azinedine456/Grid-Tied-Inverter-Design-for-a-50V-PV-Array/README.md

# Grid-Tied-Inverter-Design-for-a-50V-PV-Array

This is the github reposity of an academic project at the EiCNAM. (LTspice model uses the [LTspiceControlLibrary-master](https://github.com/kanedahiroshi/LTspiceControlLibrary) library.) 

## Project Objectives 
- Developing the methodological skills necessary to effectively plan and manage a technical project.
- Designing & properly sizing an inverter leg that meets project specifications.
- Simulating a full inverter on LTspice.
- Experimenting with different controllers & evaluating current control system performance (Proportional / Hysterisis). 

## LTSpice Ciruict & Simulation 
- High current peaks are due to  diode reverse recovery current => LC input filter needed.



## Results (Hysterisis Controller Implementation on Arduino)
TEK00016

-Pink: Current 
-Red: Current Reference
-Blue: Grid Voltage

## Sizing xlsx File Overview
