azinedine456/Grid-Tied-Inverter-Design-for-a-50V-PV-Array/Project Files /LTspice/ReadMe.Md

# All files ending in ANALOG contain a conventional implementation of the hysterisis controller.

# All files ending in PWN contain a PWM implementation of the hysterisis controller.
