azinedine456/Grid-Tied-Inverter-Design-for-a-50V-PV-Array/Project Files /LTspice/IDEAL SWITCH TEST.asc

B1: bv; V=V(sourceh1,sourceh3)
C1: cap; 10m
D1: diode; IDD
D2: diode; IDD
D3: diode; IDD
D4: diode; IDD
D5: diode; IDI
D6: diode; IDI
D7: diode; IDI
D8: diode; IDI
IDi1: voltage; 0
IDi2: voltage; 0
IDpv1: voltage; 0
L1: ind; 1µ
Lreseau1: ind; {Lr}
R1: res; R=if(V(vc1)>0.5,Rdson,Roc)
R2: res; R=if(V(vc2)>0.5,Rdson,Roc)
R3: res; R=if(V(vc2)>0.5,Rdson,Roc)
R4: res; R=if(V(vc1)>0.5,Rdson,Roc)
Rreseau1: res; {Rr}
U2: PWM; Vin1=0 Vin2=1 Tperiod=1e-4; Tdelay=0 tripdt=Tdead
U3: ComplementaryBufferWithDeadtime; Tdead={Tdead} tripdt={Tdead} *0.5
U4: ComplementaryBufferWithDeadtime; Tdead={Tdead} tripdt={Tdead} *0.5
V1: voltage; SINE(0.5 0.442 50 0 0 6)
Vpv1: voltage; 80
Vreseau1: voltage; SINE(0 70.71 50 0 0 0)
Named nets: 0, vpv, vc1, vc2, mod, res, sourceh1, sourceh3, Voutfilt
.param Rdson=0.26 Roc=3e6 Rg=0.1 Rr=1m Lr=2.4m Tdead=10p
.tran 0 0.08 0.06 1e-6
.model IDD D(Ron=Rdson Roff=1Meg Vfwd=0)
ondes d'onduleur filtrées a fc= 1591Hz
.model IDI D(Ron=10e-4 Roff=1Meg Vfwd=0)
