azinedine456/Grid-Tied-Inverter-Design-for-a-50V-PV-Array/Project Files /LTspice/BRASONDUL.asc

B1: bv; V=V(vc1)*V(Vdrive)
B2: bv; V=V(vc2)*V(Vdrive)
B3: bv; V=V(vc2)*V(Vdrive)
B4: bv; V=V(vc1)*V(Vdrive)
B5: bv; V=V(sourceh1,sourceh3)
C1: cap; 0.1µ
C2: cap; 0.1µ
C3: cap; 0.1µ
C4: cap; 0.1µ
C5: cap; 10m
D1: diode; 1N4007
D2: diode; 1N4007
D3: diode; 1N4007
D4: diode; 1N4007
ID1: voltage; 0
ID2: voltage; 0
IDi1: voltage; 0
IDi2: voltage; 0
IDpv: voltage; 0
L1: ind; 1µ
Lreseau1: ind; {Lr}
Rg1: res; {Rg}
Rg2: res; {Rg}
Rg3: res; {Rg}
Rg4: res; {Rg}
Rin1: res; {Rin}
Rin2: res; {Rin}
Rin3: res; {Rin}
Rin4: res; {Rin}
Rreseau: res; {Rr}
U1: TLP5702
U2: TLP5702
U3: TLP5702
U4: TLP5702
U5: irf520n
U6: irf520n
U7: irf520n
U8: irf520n
U9: PWM; Vin1=0 Vin2=1 Tperiod=1e-4
U10: ComplementaryBufferWithDeadtime; Tdead={Tdead} tripdt={Tdead} *0.5
U11: ComplementaryBufferWithDeadtime; Tdead={Tdead} tripdt={Tdead} *0.5
V1: voltage; SINE(0.5 0.442 50 0 0 12)
Valimdriv: voltage; 10
Vpv1: voltage; 80
Vreseau: voltage; SINE(0 70.71 50 0 0 0)
Vsuph1: voltage; 10
Vsuph2: voltage; 10
Vsupl1: voltage; 10
Named nets: 0, vsupl, vsuph1, vsuph3, sourceh1, sourceh3, vpv, o1, o2, o4, o3, cathode, vc1, vc2, mod, Voutfilt, res, Vdrive
.lib C:\\Users\\ZinouAb\\Downloads\\TLP5702_LTspice_20190327\\TLP5702.mod
.tran 0 0.08 0.06 1e-6
.param Rg=10 Rr=1m Lr=2.4m Tdead=3µ Rin=1000
.lib C:\\Users\\ZinouAb\\Downloads\\TLP5702_LTspice_20190327\\irf520n.lib
ondes d'onduleur filtrées a fc= 1591Hz
.model IDI D(Ron=10e-3 Roff=1Meg Vfwd=0)
