azinedine456/Grid-Tied-Inverter-Design-for-a-50V-PV-Array/Project Files /LTspice/HalfbridgeHysterisisANALOG.asc

B1: bv; V=V(vc1)*V(Vdrive)
B2: bv; V=V(vc2)*V(Vdrive)
B3: bv; V=I(Lreseau1)
B4: bv; V=V(ref)-V(mes)
B5: bv; V=-V(vdrive)
C1: cap; 0.1µ
C2: cap; 0.1µ
C3: cap; {C}
C4: cap; {C}
D1: diode; 1N4007
D2: diode; 1N4007
ID1: voltage; 0
ID2: voltage; 0
IDi1: voltage; 0
IDi2: voltage; 0
IDpv1: voltage; 0
Lreseau1: ind; {Lr}
R1: res; 10K
Rg1: res; {Rg}
Rg2: res; {Rg}
Rin1: res; {Rin}
Rin2: res; {Rin}
Rreseau1: res; {Rr}
U1: TLP5702
U2: TLP5702
U3: LTC1843
U4: ComplementaryBufferWithDeadtime; Tdead={Tdead} tripdt={Tdead} *0.5
U5: irf520n
U6: irf520n
U7: ComplementaryBufferWithDeadtime; Tdead={Tdead} tripdt={Tdead} *0.5
V1: voltage; SINE(0 9 50 0 0 0)
V2: voltage; {hyst}
Valimdriv1: voltage; 10
Vpv1: voltage; 80
Vreseau1: voltage; SINE(0 35.35 50 0 0 0)
Vsuph1: voltage; 10
Vsuph2: voltage; 10
Vsupl1: voltage; 10
Named nets: 0, vsupl, vsuph1, sourceh1, sourceh3, vpv, vsuph3, o1, o2, cathode, res, Vdrive, ref, mes, diff, vc1, vc2
.lib C:\\Users\\ZinouAb\\Downloads\\TLP5702_LTspice_20190327\\TLP5702.mod
.tran 0 0.08 0.06 1e-6
.param Rin=1000 Rg=10 Rr=1m Lr=2.4m C = 11.69m hyst=1e-2 step=0.5 Tdead=3µ
.lib C:\\Users\\ZinouAb\\Downloads\\TLP5702_LTspice_20190327\\irf520n.lib
.model IDI D(Ron=10e-3 Roff=1Meg Vfwd=0)
Voltage sources (PV, Drive..etc)
Hysterisis Controller
