azinedine456/Grid-Tied-Inverter-Design-for-a-50V-PV-Array/Project Files /LTspice/HalfbridgeHysterisisIdealControlPWM.asc

B1: bv; V=I(Lreseau1)
B2: bv; V=V(ref)-V(mes)
B3: bv; V=if(  V(tim)>0.5,  if(V(diff)>hyst,step,    if(V(diff)<hyst,-step,0)    )      ,0     )
B4: bv; V=((V(sum)+V(res,sourceh3))/  (V(vpv)*0.5)   )*0.5 +0.5
C1: cap; {C}
C2: cap; {C}
D3: diode; IDD
D4: diode; IDD
D5: diode; IDI
D6: diode; IDI
IDi1: voltage; 0
IDi2: voltage; 0
IDpv1: voltage; 0
Lreseau1: ind; {Lr}
R1: res; R=if(V(vc1)>0.5,Rdson,Roc)
R2: res; R=if(V(vc2)>0.5,Rdson,Roc)
Rreseau1: res; {Rr}
U1: PWM; Vin1=0 Vin2=1 Tperiod=1e-4; Tdelay=0 tripdt=Tdead
U2: ComplementaryBufferWithDeadtime; Tdead={Tdead} tripdt={Tdead} *0.5
U3: ComplementaryBufferWithDeadtime; Tdead={Tdead} tripdt={Tdead} *0.5
U4: Integral; T=0.25e-5
V1: voltage; SINE(0 9 50 0 0 0)
V2: voltage; PULSE(0 1 0 10p 10p 0.25e-5 0.5e-5)
Valimdriv1: voltage; 10
Vpv1: voltage; 80
Vreseau1: voltage; SINE(0 35.35 50 0 0 0)
Vsuph1: voltage; 10
Vsuph2: voltage; 10
Vsupl1: voltage; 10
Named nets: 0, vpv, res, sourceh1, vsupl, vsuph1, vsuph3, sourceh3, cathode, Vdrive, vc1, vc2, mod, ref, mes, diff, sum, tim
.param Rdson=0.27  Roc=3e6 Rg=0.1 Rr=1µ Lr=2.4m C=30m hyst=1e-2 step=0.5 Tdead=3µ
.tran 0 0.10 0.08 1e-6
.model IDD D(Ron=Rdson Roff=1Meg Vfwd=0)
.model IDI D(Ron=10e-4 Roff=1Meg Vfwd=0)
Hysterisis Controller
Voltage sources (PV, Drive..etc)
