azinedine456/Grid-Tied-Inverter-Design-for-a-50V-PV-Array/Project Files /LTspice/HysterisisIdealANALOG.asc

B1: bv; V=-V(vdrive)
B2: bv; V=I(Lreseau1)
B3: bv; V=V(ref)-V(mes)
D1: diode; IDD
D2: diode; IDD
D3: diode; IDD
D4: diode; IDD
D5: diode; IDI
D6: diode; IDI
D7: diode; IDI
D8: diode; IDI
IDi1: voltage; 0
IDi2: voltage; 0
IDpv1: voltage; 0
Lreseau1: ind; {Lr}
R1: res; R=if(V(vc1)>0.5,Rdson,Roc)
R2: res; R=if(V(vc2)>0.5,Rdson,Roc)
R3: res; R=if(V(vc2)>0.5,Rdson,Roc)
R4: res; R=if(V(vc1)>0.5,Rdson,Roc)
R5: res; 10K
Rreseau1: res; {Rr}
U5: LTC1843
U6: ComplementaryBufferWithDeadtime; Tdead={Tdead} tripdt={Tdead} *0.5
U7: ComplementaryBufferWithDeadtime; Tdead={Tdead} tripdt={Tdead} *0.5
V1: voltage; SINE(0 9 50 0 0 0)
V3: voltage; {hyst}
Valimdriv1: voltage; 10
Vpv1: voltage; 80
Vreseau1: voltage; SINE(0 70.71 50 0 0 0)
Named nets: 0, vpv, res, sourceh1, sourceh3, ref, mes, diff, vc1, vc2, Vdrive, cathode
.param Rdson=0.27 Roc=3e6 Rg=0.1 Rr=1m Lr=2.4m hyst=1 Tdead=3µ
.tran 0 0.10 0.08 1e-6
.model IDD D(Ron=Rdson Roff=1Meg Vfwd=0)
.model IDI D(Ron=10e-4 Roff=1Meg Vfwd=0)
Hysterisis Controller
Voltage sources (PV, Drive..etc)
