azinedine456/Grid-Tied-Inverter-Design-for-a-50V-PV-Array/Project Files /LTspice/TRANSFERTPUISSANCE.asc

Lreseau1: ind; {Lr}
Rreseau1: res; {Rr}
V1: voltage; SINE(0 70.71 50 0 0 3)
Vreseau1: voltage; SINE(0 70.71 50 0 0 0)
Named nets: res, 0, out
.param Rg=10 Rr=20m Lr=1.6m threetau=10*Lr/Rr
.tran 0 3 {threetau} 1e-3
