azinedine456/Grid-Tied-Inverter-Design-for-a-50V-PV-Array/(commit log)

2025-10-16 Rename Rapport Final - Conception de bras d'onduleur.pdf to (Report in French ) Rapport Final - Conception de bras d'onduleur.pdf
2025-10-19 Rename (Report in French ) Rapport Final - Conception d'un onduleur à depi-pont capacitif connecté au réseau.pdf.pdf to (Report in French ) Rapport Final - Conception d'un onduleur à demi-pont capaci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
